ograsdijk/CeNTREX-pcb/tec control/mtd415te/rev 3.0/board_layout.pdf

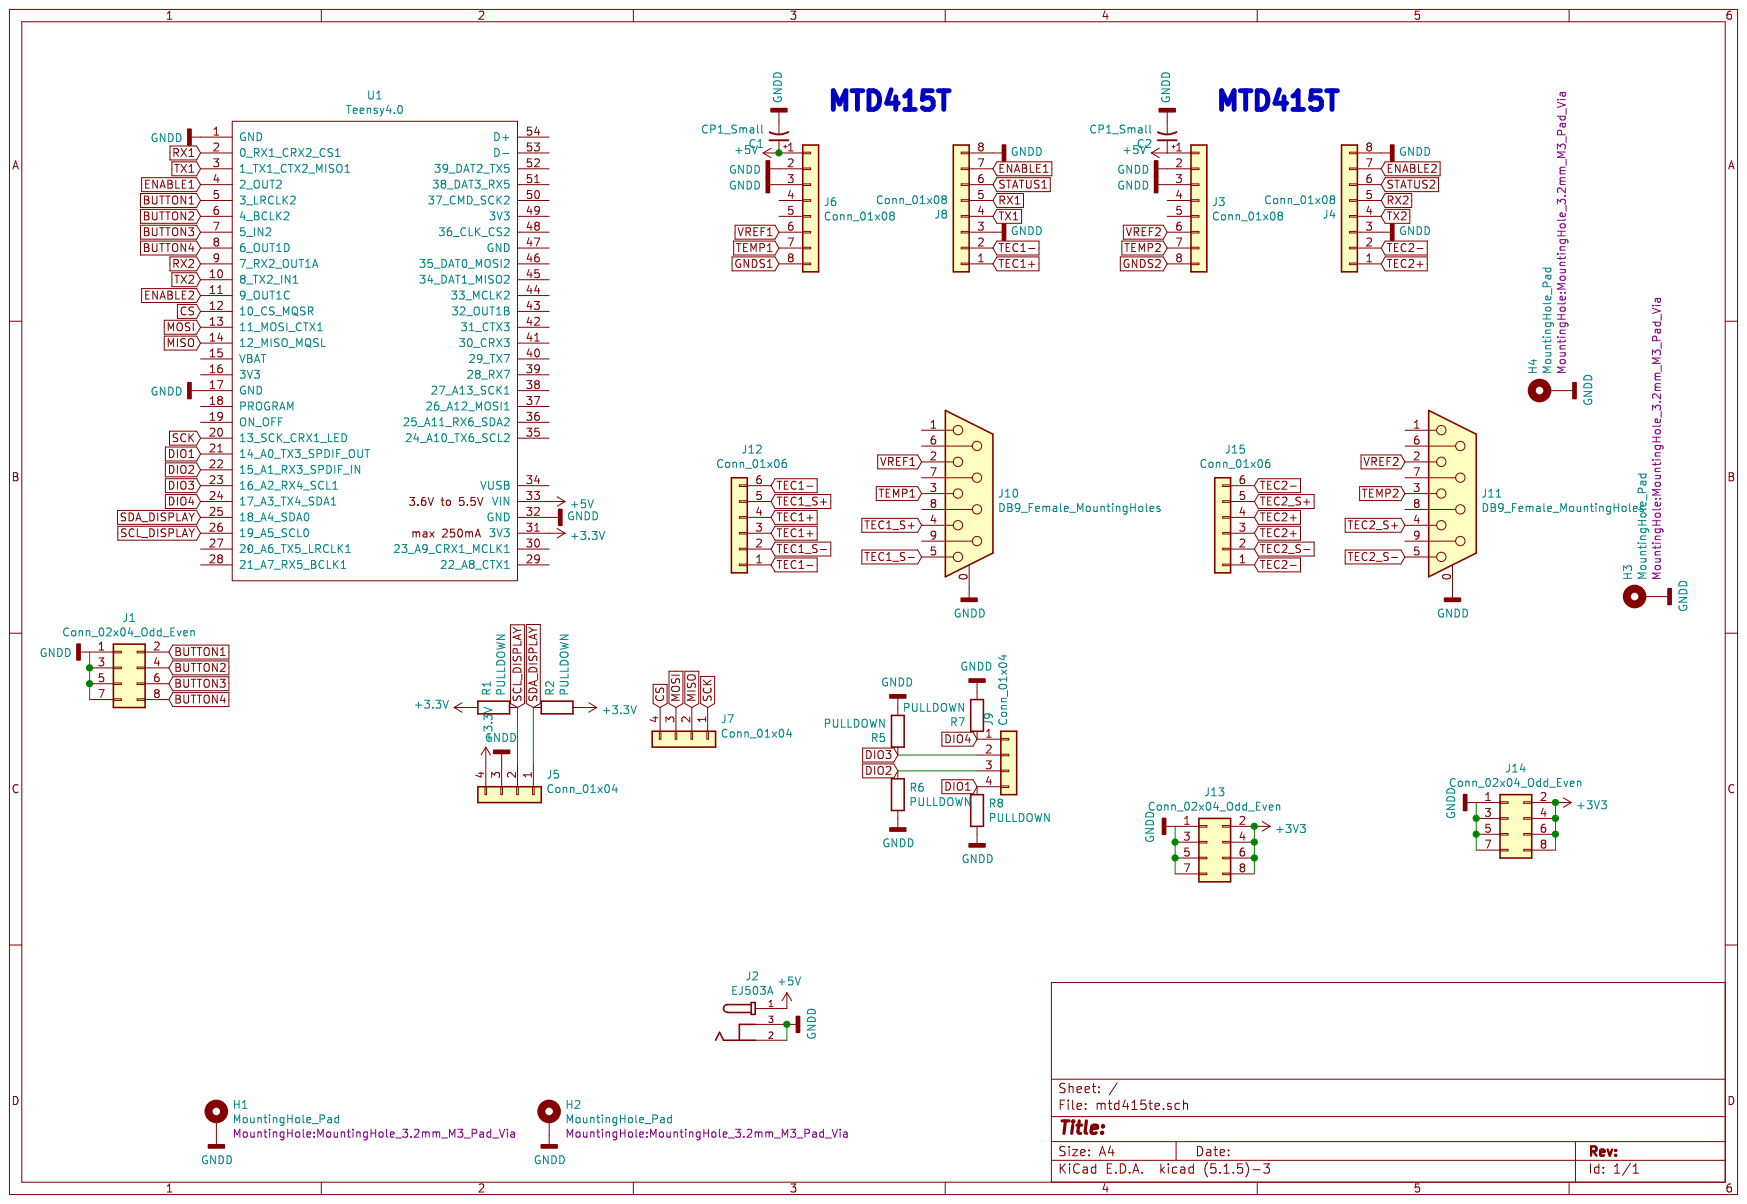
[picture p3: page 1]
