ograsdijk/CeNTREX-pcb/(commit log)

2019-08-23 Fixed mistakes in interlock pcbs
    [relay_ctrl_compressor_cabinet.kicad_pcb, relay_ctrl_lab.kicad_pcb]
2019-08-27 PulseBlaster Clock Buffer Rev 2.0
    Flipped layout, pinheader on pulseblaster board was in the way.
    [clock_buffer-B_Cu.gbr, clock_buffer-B_Mask.gbr, clock_buffer-B_Paste.gbr, clock_buffer-B_SilkS.gbr, clock_buffer-Edge_Cuts.gbr, clock_buffer-F_Cu.gbr, clock_buffer-F_Mask.gbr, clock_buffer-F_Paste.gbr]
2019-08-27 PulseBlaster Clock Buffer Rev 2.0
    Added optional 50Ohm buffer output termination
    [clock_buffer-B_Cu.gbr, clock_buffer-B_Mask.gbr, clock_buffer-B_Paste.gbr, clock_buffer-B_SilkS.gbr, clock_buffer-Edge_Cuts.gbr, clock_buffer-F_Cu.gbr, clock_buffer-F_Mask.gbr, clock_buffer-F_Paste.gbr]
2019-08-27 PulseBlaster Clock Buffer Rev 2.0 add dimensions
    [clock_buffer.kicad_pcb]
2019-11-26 Single ended to differential opamp circuit for NKT Seed laser frequency modulation
    [NKT Basik single ended to differential modulation.kicad_pcb, NKT Basik single ended to differential modulation.sch]
2019-11-26 Moved files
    [amplifier-B_Cu.gbr, amplifier-B_Mask.gbr, amplifier-B_Paste.gbr, amplifier-B_SilkS.gbr, amplifier-Edge_Cuts.gbr, amplifier-F_Cu.gbr, amplifier-F_Mask.gbr, amplifier-F_Paste.gbr]
2020-07-01 Cavity Locking PCB improvements
    [output_amplifier.sch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]
2020-07-01 Solid State Scope Multiplexer for 3 cavities
    4x 3->1
    [ssr cavity multiplexer-B_Cu.gbr, ssr cavity multiplexer-B_Mask.gbr, ssr cavity multiplexer-B_Paste.gbr, ssr cavity multiplexer-B_SilkS.gbr, ssr cavity multiplexer-Edge_Cuts.gbr, ssr cavity multiplexer-F_Cu.gbr, ssr cavity multiplexer-F_Mask.gbr, ssr cavity multiplexer-F_Paste.gbr]
2020-07-01 TEC Control board improvements
    [mtd415te-B_Cu.gbr, mtd415te-B_Mask.gbr, mtd415te-B_Paste.gbr, mtd415te-B_SilkS.gbr, mtd415te-Edge_Cuts.gbr, mtd415te-F_Cu.gbr, mtd415te-F_Mask.gbr, mtd415te-F_Paste.gbr]
2020-07-01 Teensy DIO for computer control of digital sigals with access to counters etc.
    [teensy dio.kicad_pcb, teensy dio.sch]
2020-08-06 scope multiplexer
    [16 input multiplexer.kicad_pcb, 16 input multiplexer.sch, 3 cavity multiplexer.kicad_pcb, 3 cavity multiplexer.sch]
2020-08-06 Pitaya updates
    [output_amplifier.sch]
2020-09-23 converted for new version of kicad
2020-09-23 Add tec control pcbs
    [mtd415te-B_Cu.gbr, mtd415te-B_Mask.gbr, mtd415te-B_Paste.gbr, mtd415te-B_SilkS.gbr, mtd415te-Edge_Cuts.gbr, mtd415te-F_Cu.gbr, mtd415te-F_Mask.gbr, mtd415te-F_Paste.gbr]
2020-09-23 beamsource turbo microcontroller control
    [turbotronik NT 150_360 control.kicad_pcb, turbotronik NT 150_360 control.sch]
2020-09-27 PXIe5171 mini HDMI breakout board
    [PXIe5171 PFI breakout.kicad_pcb, PXIe5171 PFI breakout.sch]
2020-09-28 Added gerber files
    [mtd415te-B_Cu.gbr, mtd415te-B_Mask.gbr, mtd415te-B_Paste.gbr, mtd415te-B_SilkS.gbr, mtd415te-Edge_Cuts.gbr, mtd415te-F_Cu.gbr, mtd415te-F_Mask.gbr, mtd415te-F_Paste.gbr]
2020-10-09 Removed superfluous libraries
    [PXIe5171 PFI breakout.sch]
2020-10-10 corrected bug in pin label on pcb
    [mtd415te.kicad_pcb]
2021-09-15 Adde BOM for tec control rev 3.0
    [mtd415te.csv]
2021-09-17 fixed capacitor value
